VitRuzicka/3DfilamentScale/README.md

no big words here <br>
hx711 connected to WEMOS D1 mini with I2C OLED display showing all the stuff <br>
writeup included <br>
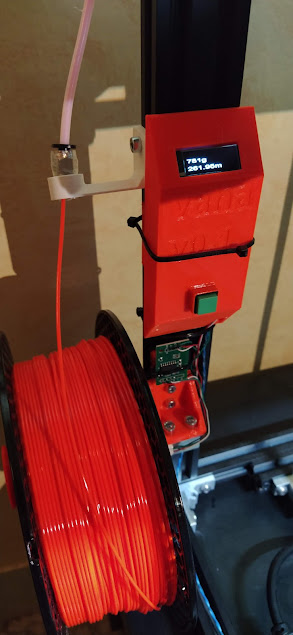
[picture p1: IMG_20220218_203244.jpg]
