VitRuzicka/3DfilamentScale/Váha na filament.pdf

# Váha na filament s odhadem zbývajícího množství

## budeme potřebovat:

Vahovy senzor 5 kg pro kuchynske vahy | dratek.cz (https://dratek.cz/arduino/1119-hmotnostni-senzor-5-kg-pro-kuchynske-vahy.html)
Arduino AD převodník 24-bit 2 kanály HX711 | dratek.cz (https://dratek.cz/arduino/998-ad-prevodnik-modul-24-bit-2-kanaly-hx711.html)
WeMos D1 mini Lite V1.0.0 wifi vývojová deska IOT Internet věcí 1MB Flash | dratek.cz (https://dratek.cz/arduino/1979-wemos-d1-mini-lite-v1.0.0-wifi-vyvojova-deska-iot-1mb-flash-esp8285.html)
Mini Step Down Buck napájecí modul 3A DC 5-23 na DC 1-17 | dratek.cz (https://dratek.cz/arduino/3133-mini-step-down-buck-napajeci-modul-3a-dc-5-23-na-dc-1-17.html)
IIC I2C Displej OLED 0.91" 128x32 Bílý 3,3 V 5V Pro IOT Arduino Raspberry | dratek.cz (https://dratek.cz/arduino/1479-iic-i2c-displej-oled-0.91-128x32-bily-3-3-v-5v-pro-iot-arduino-raspbery.html)
Vodotěsný spínač 12mm - černý | dratek.cz (https://dratek.cz/arduino/5411-vodotesny-spinac-12mm-cerny.html)

## Zapojení

Zapojíme OLED display na I2C piny na Wemosu d1 mini (SDA, SCL), tyto piny pak nadefinujeme v kódu.

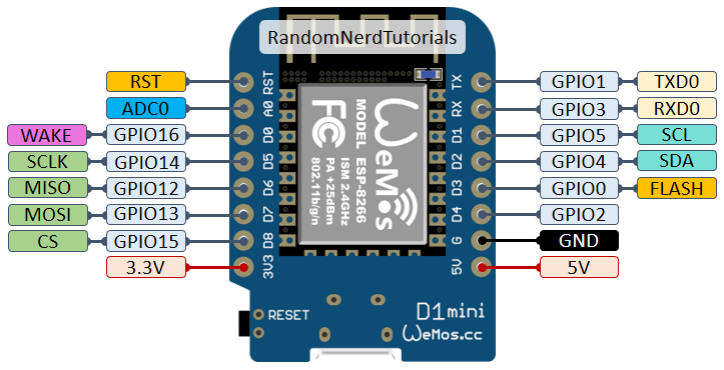
[picture p2: figure]

Tlačítko můžeme připojit například na pin GPIO14. proti zemi.

HX7144 připojíme (DT na GPIO16 a SCK na GPIO2)

Nahrajeme kód do esp.

Na vstupní svorky stepdown converteru přivedeme napětí 24V (napětí z tiskárny) a za pomocí otáčení trimru a měření napětí na výstupu nastavíme napěťovou úroveň 5v. Nyní můžeme připojit i converter k 5v a gnd pinech na wemosu.

Připojíme i tenzometr na převodník podle následujícího schématu.

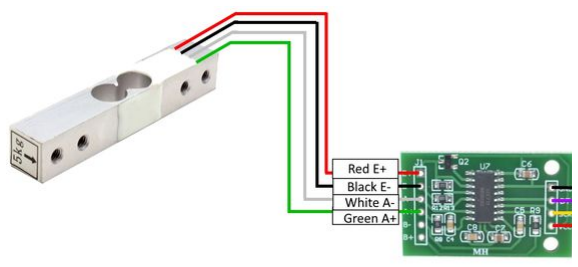
[picture p3: figure]

## Popis

Jedná se o digitální váhu, která odečítá váhu přípravku a předem nastavenou či nakalibrovanou váhu špulky a podle zbylé váhy vypočítává dálku zbylého filamentu. Primárně je to určeno pro PLA s PETG, jelikož mají podobnou hustotu a tím pádem podobné vlastnosti. Držáky a pomocné díly jsou vytištěné z petg. Stl jsou k dispozici zde:

Spool_Scale_Project/extra/Spool_Holder_STL at master · Ed-EE-Eng/Spool_Scale_Project · GitHub (https://github.com/Ed-EE-Eng/Spool_Scale_Project/tree/master/extra/Spool_Holder_STL)

Budete také potřebovat M4x15 a matice do 20x20 profilu pro přichycení na tiskárnu

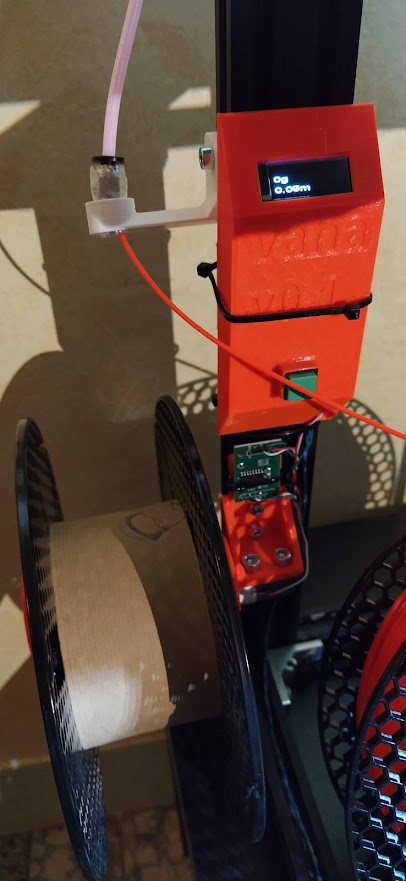
[picture p4: figure]

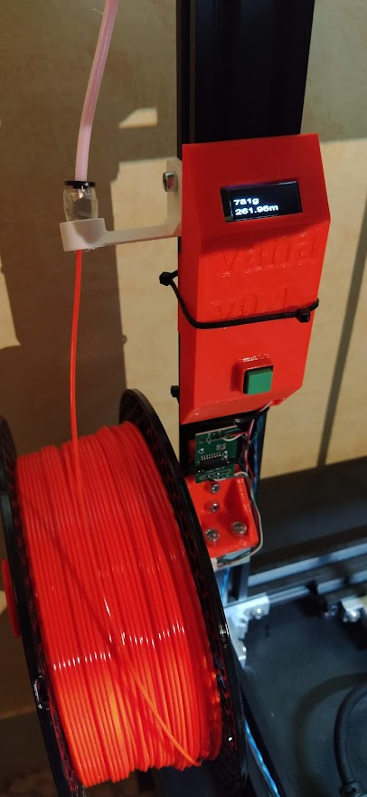
[picture p5: figure]
