VitRuzicka/3DfilamentScale/stl/kryt na vahu - Part 2.stl

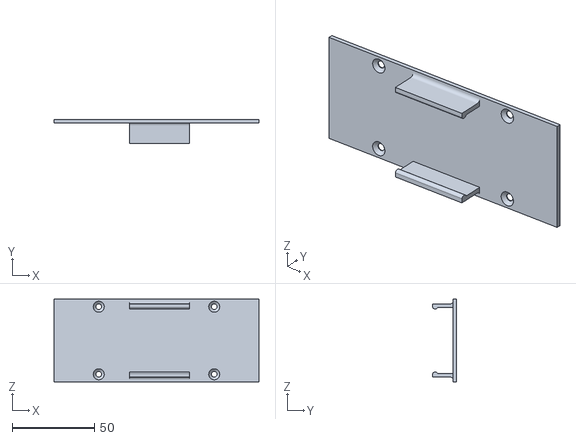
[picture p6: CAD file, 2022-02-20]
stl/kryt na vahu - Part 2.stl
124.8 x 14.5 x 50.2
