VitRuzicka/3DfilamentScale/stl/kryt na vahu - Part 1.stl

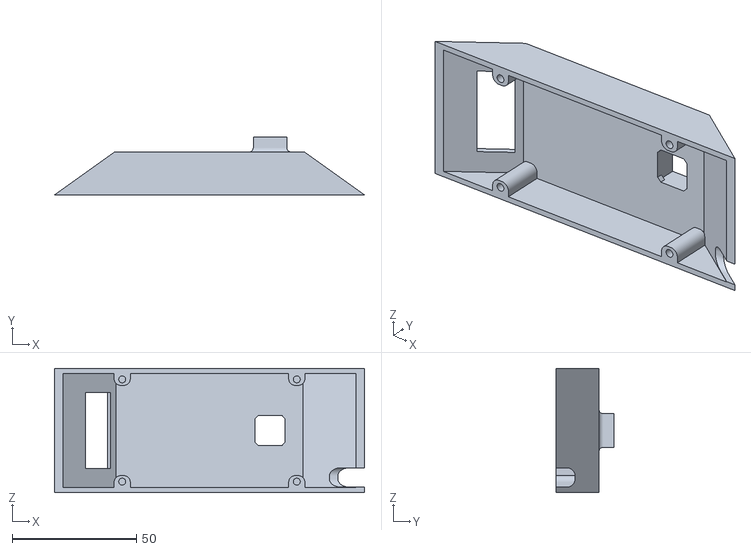
[picture p7: CAD file, 2022-02-20]
stl/kryt na vahu - Part 1.stl
124.9 x 23.3 x 50.0
